royankush/KRSSG/Mech Team Repo/SSL Bots Designs/SSL Bots V3 - 3D Printed/SSL V3 Proto Assembly.JPG

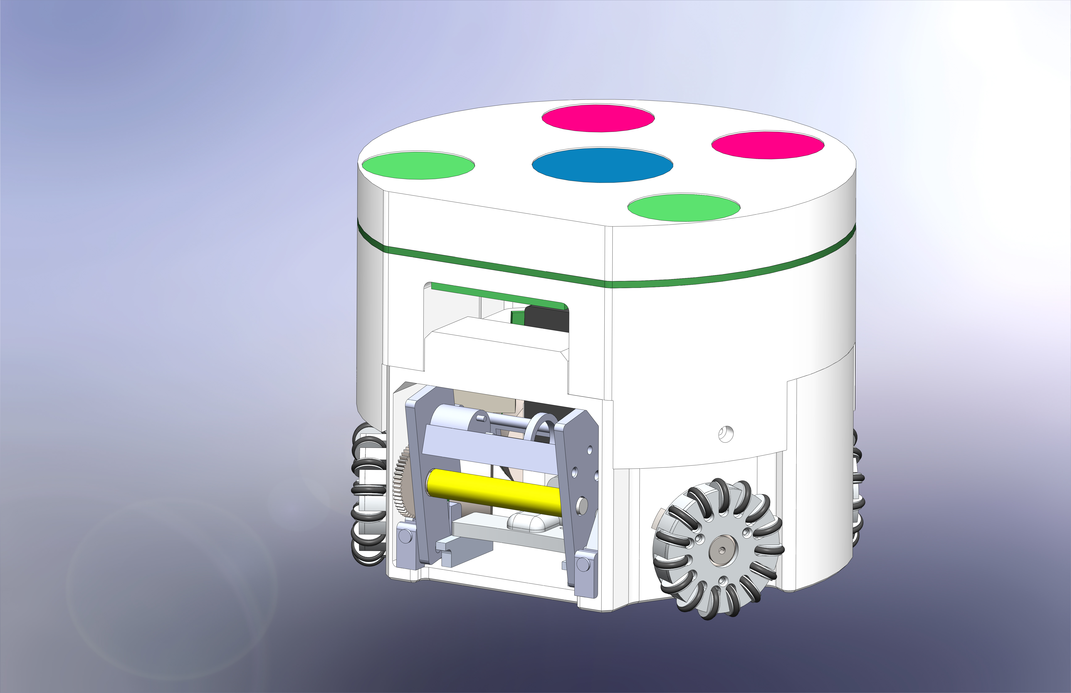
Mech Team Repo/SSL Bots Designs/SSL Bots V3 - 3D Printed/SSL V3 Proto Assembly.JPG
