royankush/KRSSG/Mech Team Repo/SSL Bots Designs/SSL Bots V2 - 2016/render.JPG

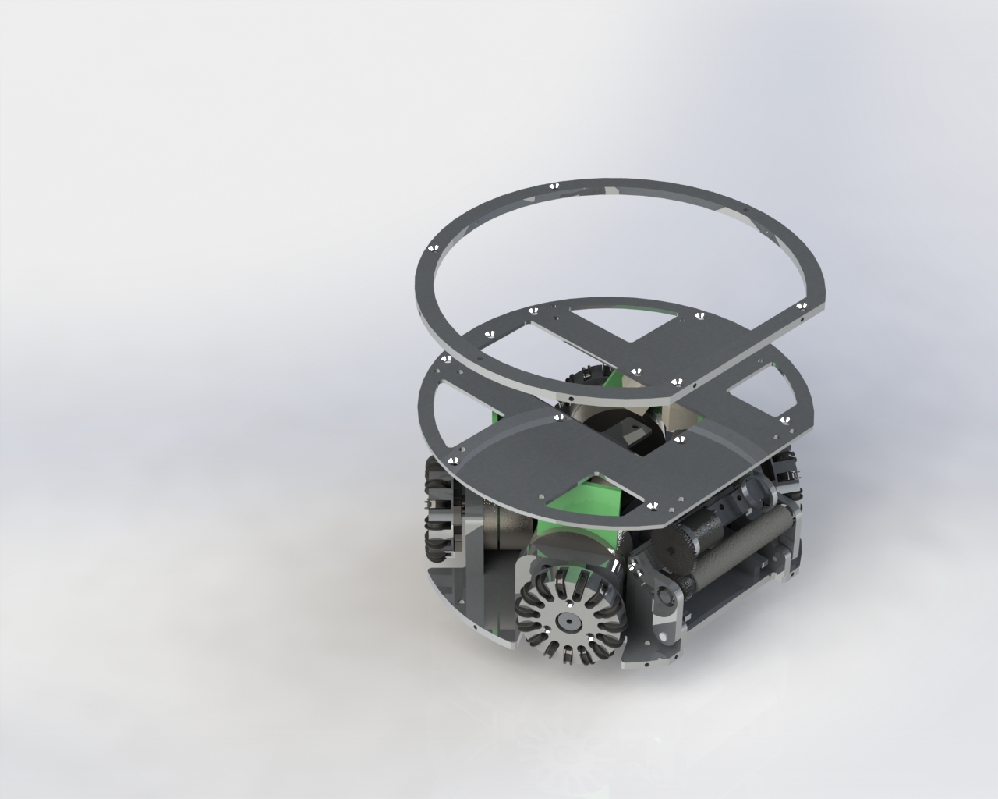
Mech Team Repo/SSL Bots Designs/SSL Bots V2 - 2016/render.JPG
