royankush/KRSSG/README.md

# KRSSG
KRSSG Repository - Mechanical design, simulations, codes and other stuff
