royankush/KRSSG/Mech Team Repo/Humanoid/humanoid_bot.md

This is a repo of humanoid robot simulations and CAD
