royankush/KRSSG/Mech Team Repo/SSL Bots Designs/EC45 motor modification.pdf

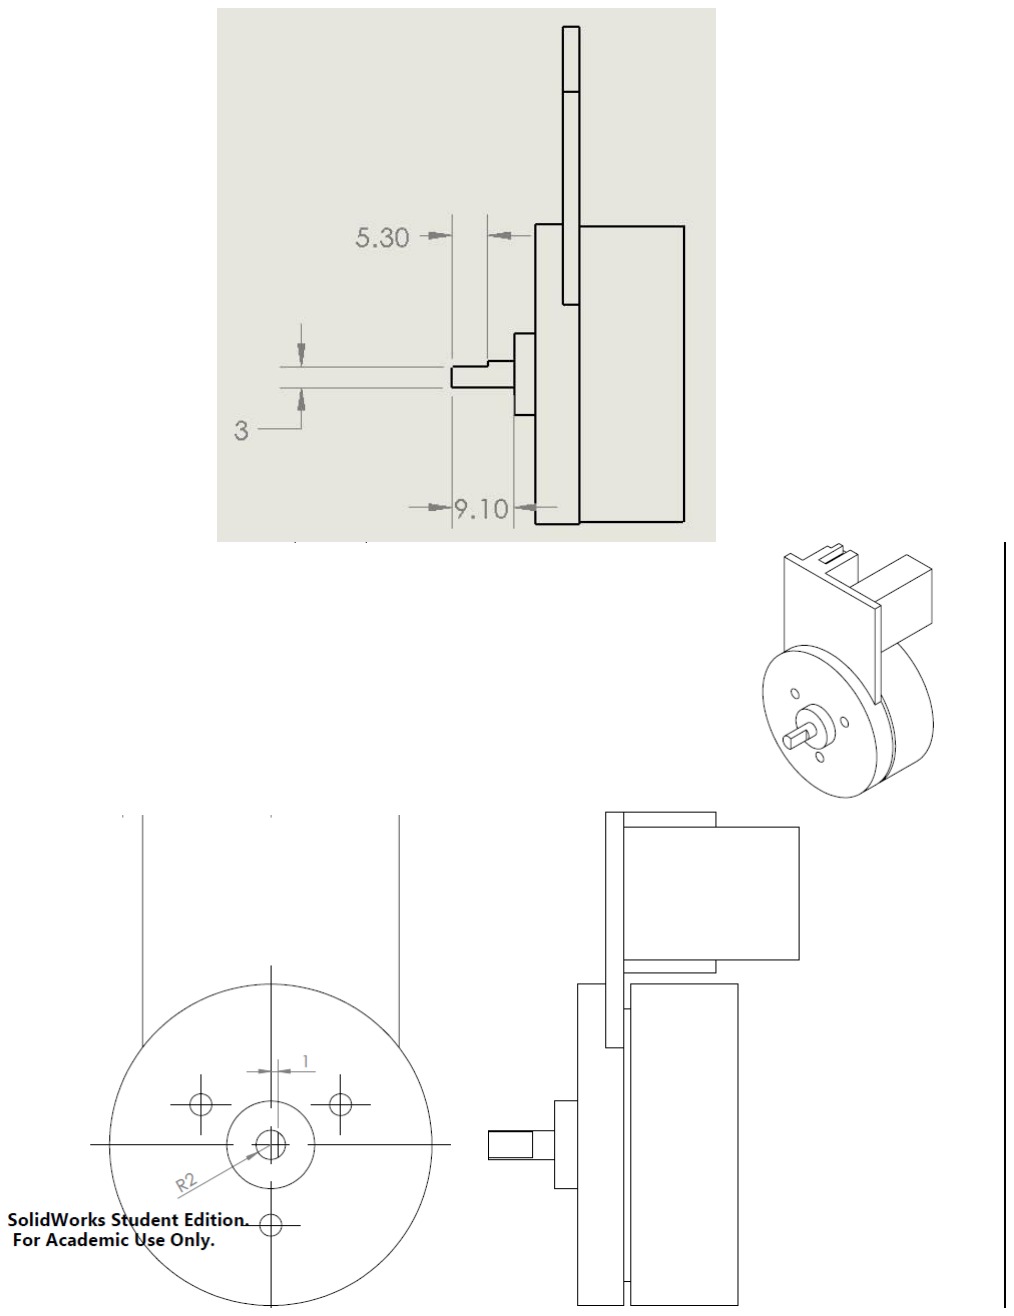
[picture p62: page 1]
