royankush/KRSSG/Mech Team Repo/Bills and Misc/Bosch toolbox.pdf

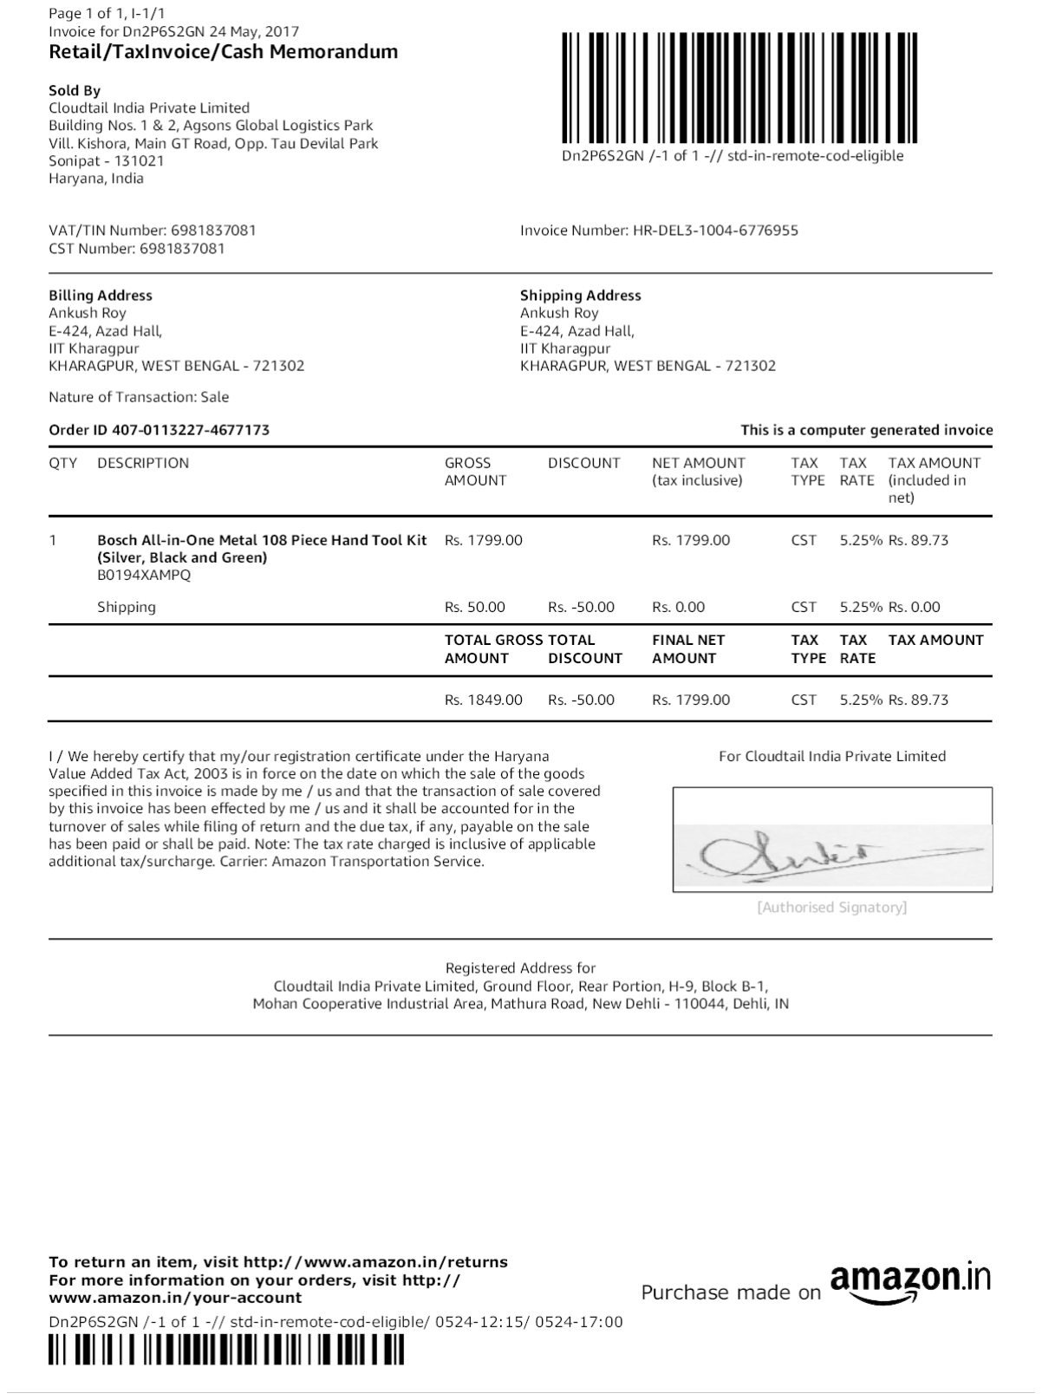
[picture p63: page 1]
