royankush/KRSSG/Mech Team Repo/Bills and Misc/SSL_v2_bill_2.jpg

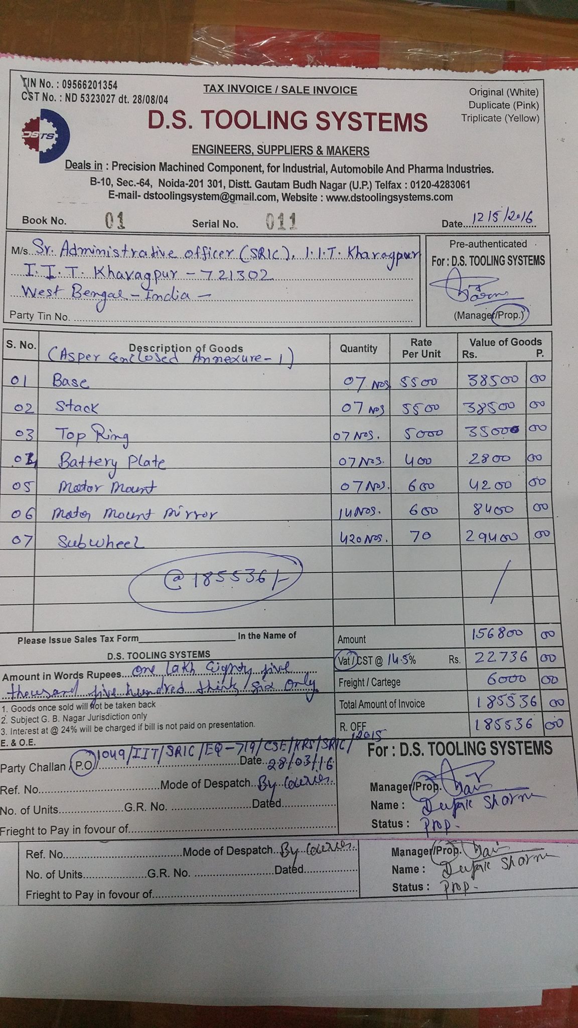
Mech Team Repo/Bills and Misc/SSL_v2_bill_2.jpg
