royankush/KRSSG/Mech Team Repo/Bills and Misc/SSL_v2_bills.jpg

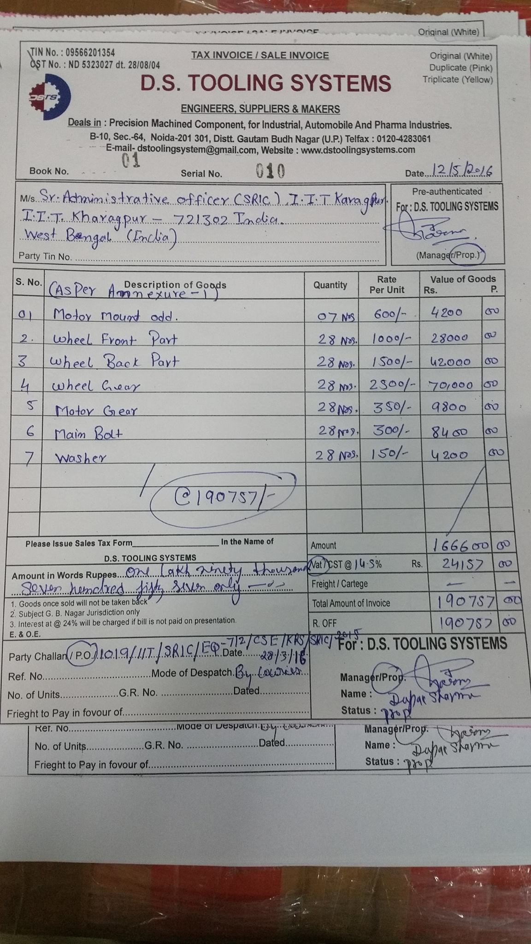
Mech Team Repo/Bills and Misc/SSL_v2_bills.jpg
