royankush/KRSSG/Mech Team Repo/Markers/full_b.jpg

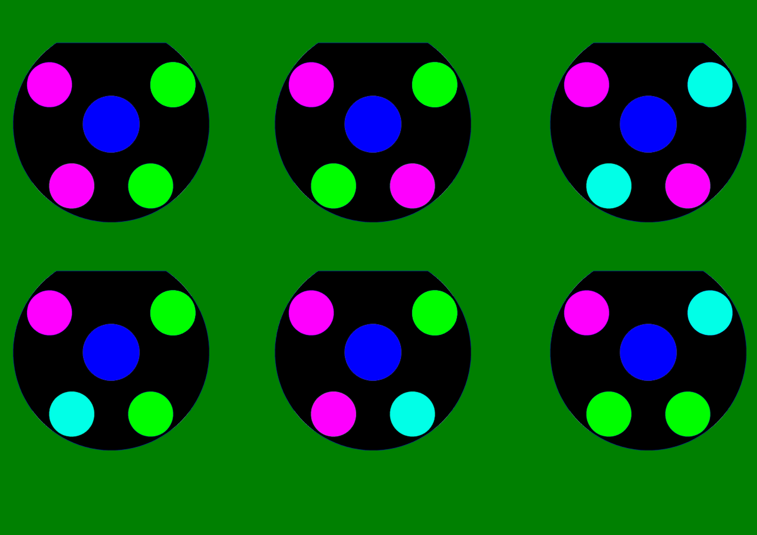
Mech Team Repo/Markers/full_b.jpg
