royankush/KRSSG/Mech Team Repo/Markers/full_y.jpg

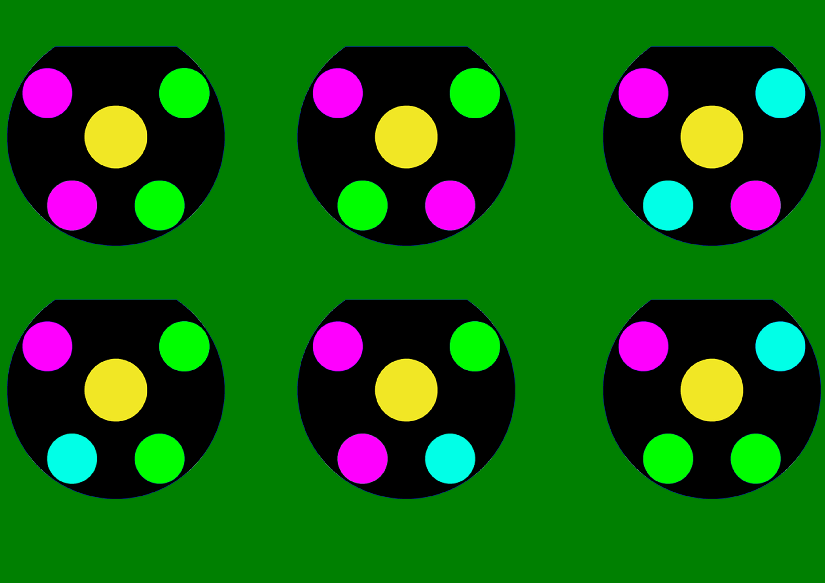
Mech Team Repo/Markers/full_y.jpg
