royankush/KRSSG/Mech Team Repo/Markers/m1.jpg

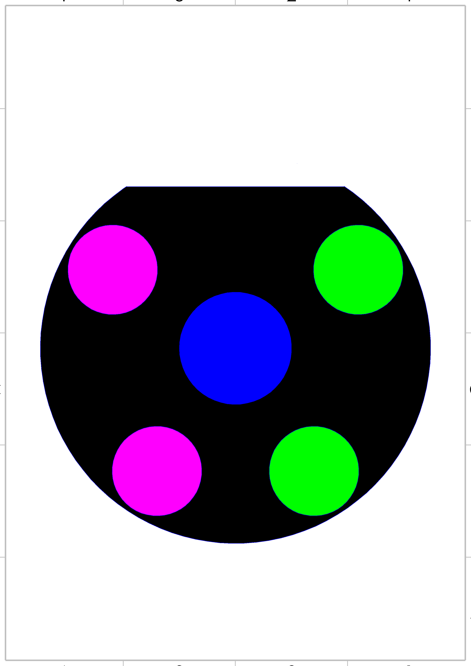
Mech Team Repo/Markers/m1.jpg
