royankush/KRSSG/Mech Team Repo/Markers/Marker.JPG

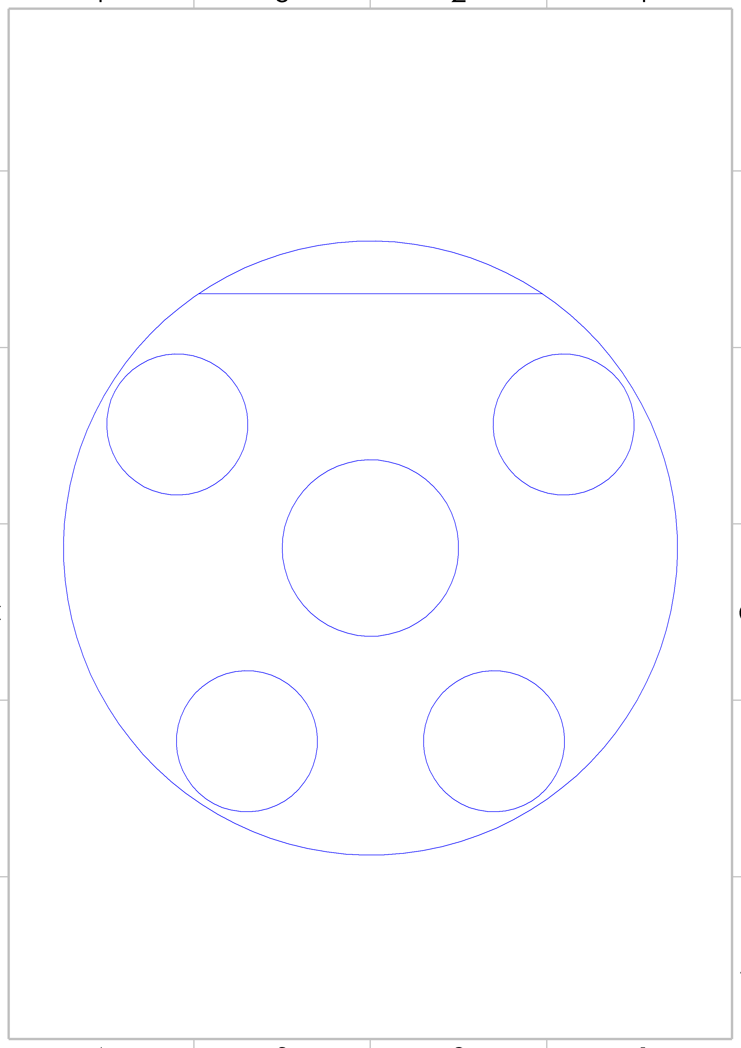
Mech Team Repo/Markers/Marker.JPG
