royankush/KRSSG/Mech Team Repo/KRSSG Mech Team- Expenses Record.xlsx

Sheet: 2018
Date of Order/Purchase | Date Recieved | Invoice No | Item | Vendor | Quantity | Total Amount | Purchaser's Name | Paid By | Type | Remarks
2018-03-24 | 2018-03-24 | 1605889 | KRSSG website renewal | BigRock | 1 | 3525 | Ankush | Ankush | Advance
2018-03-24 | 2018-03-24 |  | White Board and accessories | Thackers | 1 | 1058 | Ankush | Ankush | Advance
2018-03-25 | 2018-04-06 | MH-177761811-1718 | Firewre Card | Amazon | 1 | 3004 | Ankush | Ankush | Advance
2018-04-01 | 2018-04-13 | MH-147384671-1819 | Gel Pad | Amazon | 1 | 1390 | Ankush | Ankush | Advance
2018-05-19 |  | 20 | Dribbler V2 Prototype | Confio Engineering Solutions | 1 | 16343 | Shivam | Tanishq | Reimbursement
2018-07-20 |  | 59 | Dribbler V2 Proto and Assembly | Confio Engineering Solutions | 1 | 14514 | Prince | Tanishq | Reimbursement
2018-07-28 | 2018-07-28 | 645 | Fateners and Studs | Buraaq Enterprises | 1 | 849 | Ankush | Ankush | Reimbursement
2018-07-28 | 2018-07-28 | 724902 | Fasteners and Spacers | JC Gupta & Sons | 1 | 684 | Ankush | Ankush | Reimbursement

Sheet: 2017
Date of Order/Purchase | Date Recieved | Invoice No | Item | Quantity | Total Amount | Purchaser's Name | Paid By | Type | Remark
2017-02-05 | 2017-02-20 |  | Solenoid Winding from electrical service section | 3 | 750 | Ankush | Ankush | Reimbursement
2017-04-05 | 2017-04-05 |  | Cover Filing | 1 | 200 | Aditya | Aditya | Reimbursement |  | Note the dates are approx.
2017-05-15 | 2017-05-25 |  | Solenoid winding Chhotu Da | 3 | 750 | Ankush | Ankush | Reimbursement |  | How the contri amount has been utilized unknown
2017-05-24 | 2017-05-30 | HR-DEL3-1004-6776955 | Bosch Toolbox | 1 | 1850 | Ankush | Contri | Reimbursement |  | All items bought not there
2017-05-25 | 2017-06-01 |  | Winding | 1 | 300 | Aditya | Aditya | Reimbursement
2017-09-01 | 2017-09-01 |  | Arena Makeover | 1 | 500 | Sahoo | Ankush | Reimbursement | Total amount was 3500
2017-09-01 | 2017-09-01 |  | Arena Makeover | 1 | 500 | Sahoo | Adiya | Reimbursement | Total amount was 3500
2017-09-05 | 2017-09-15 | WB-175050041-1718 | Loctite Threadlocker | 1 | 940 | Ankush | Contri | Reimbursement

Sheet: Contri Amount
Member Name | 2016 | 2017 | 2018 | 2019 | Total
Aditya | 500 | 600 |  |  | 1100
Ankush | 500 | 1000 |  |  | 1500 | Please note this sheet is only for contri amount and not for individual expense
Kewal | 500 |  |  |  | 500
Vedansh | 500 | 1000 |  |  | 1500
Vinay | 500 | 500 |  |  | 1000
Dhananjay |  | 500 |  |  | 500
Harsh |  | 500 |  |  | 500
Prince |  | 500 |  |  | 500
Shail |  | 500 |  |  | 500
Shivam |  | 500 |  |  | 500
Virat |  | 500 |  |  | 500
