royankush/KRSSG/Mech Team Repo/Bills and Misc/Maxon motors purchase order.pdf

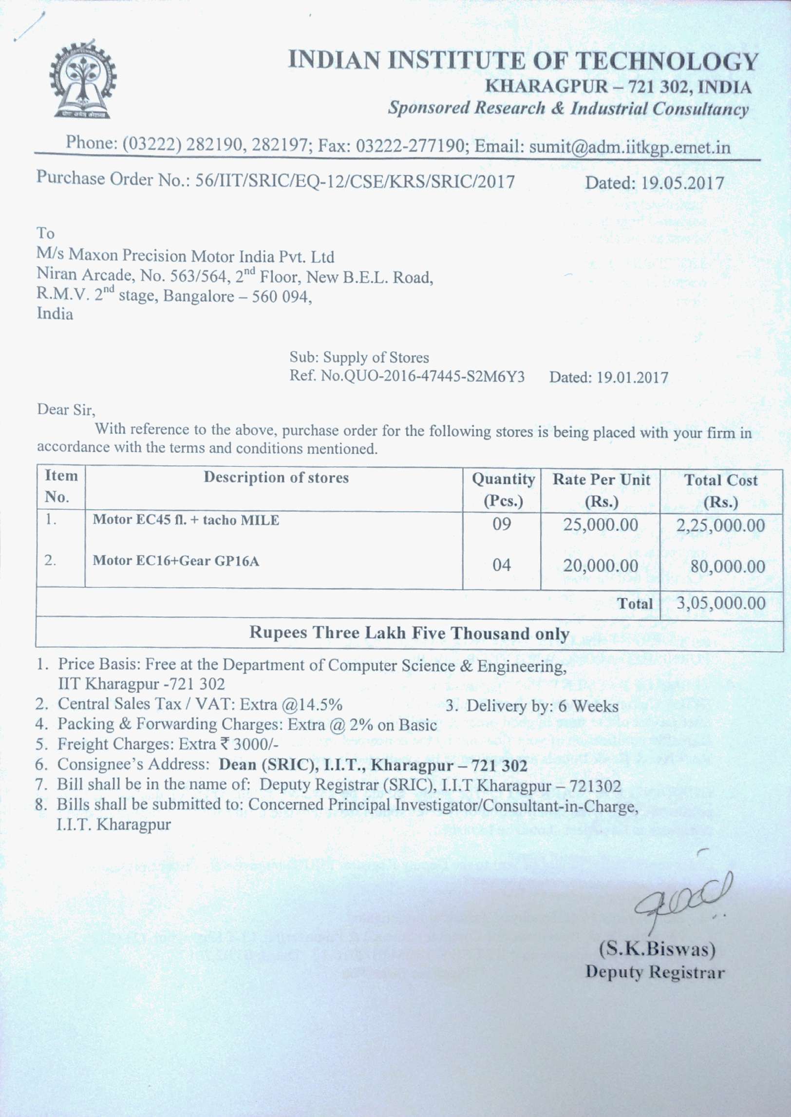
[picture p70: page 1]

Scanned by CamScanner

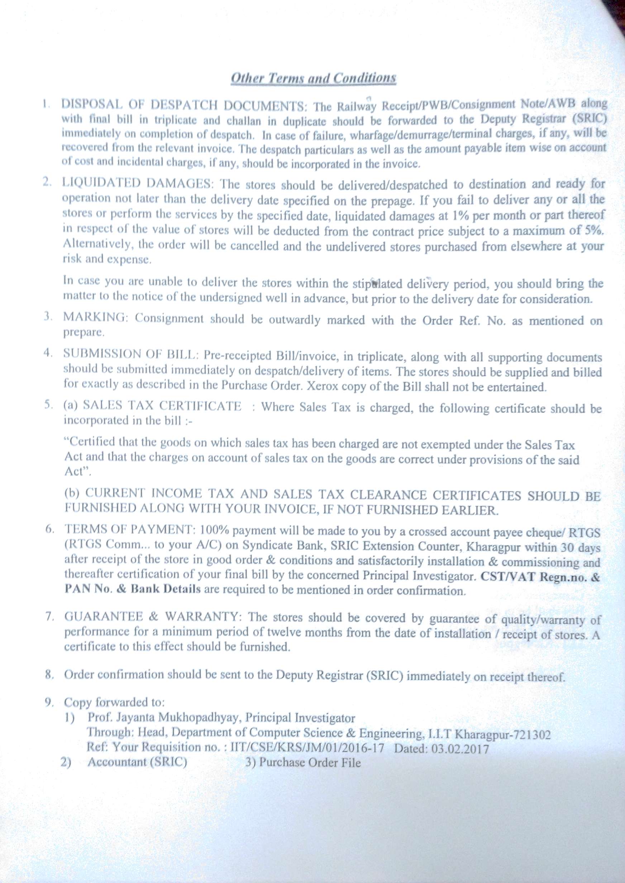
[picture p71: page 2]
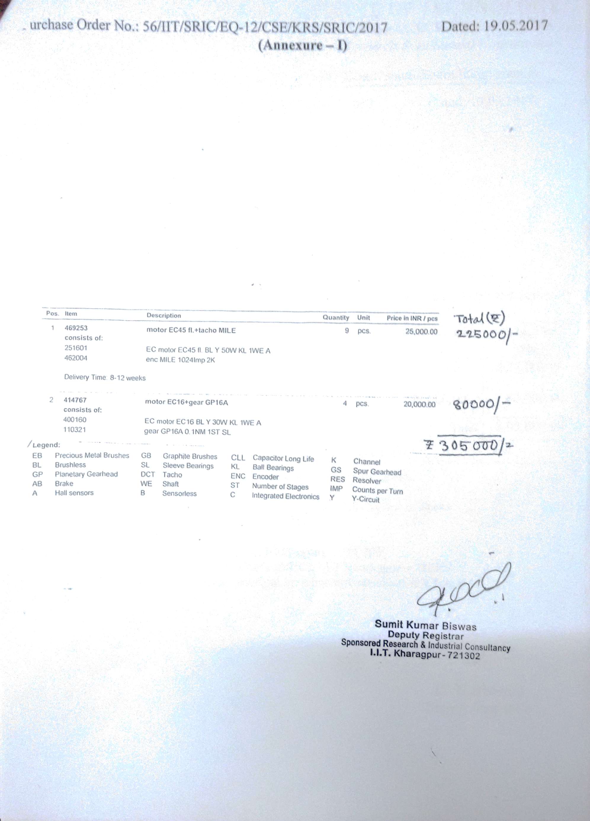
[picture p72: page 3]
