royankush/KRSSG/Mech Team Repo/SSL Bots Designs/SSL Bots V3 - 3D Printed/Main Body, Base.SLDPRT

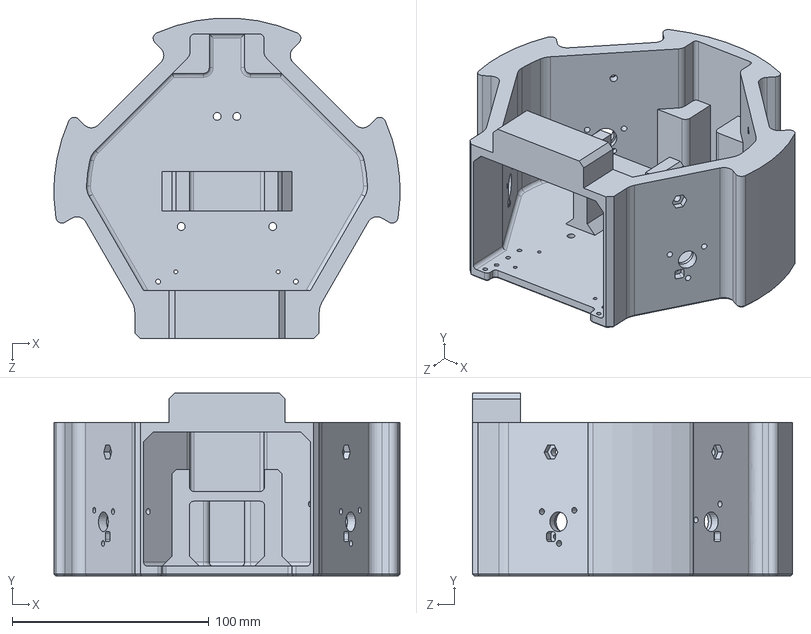
[picture p73: CAD file, 2022-12-06]
Mech Team Repo/SSL Bots Designs/SSL Bots V3 - 3D Printed/Main Body, Base.SLDPRT
175.8 x 93.0 x 162.8 mm
