royankush/KRSSG/Mech Team Repo/SSL Bots Designs/SSL Bots V3 - 3D Printed/SSL V3 Proto Assembly.SLDASM

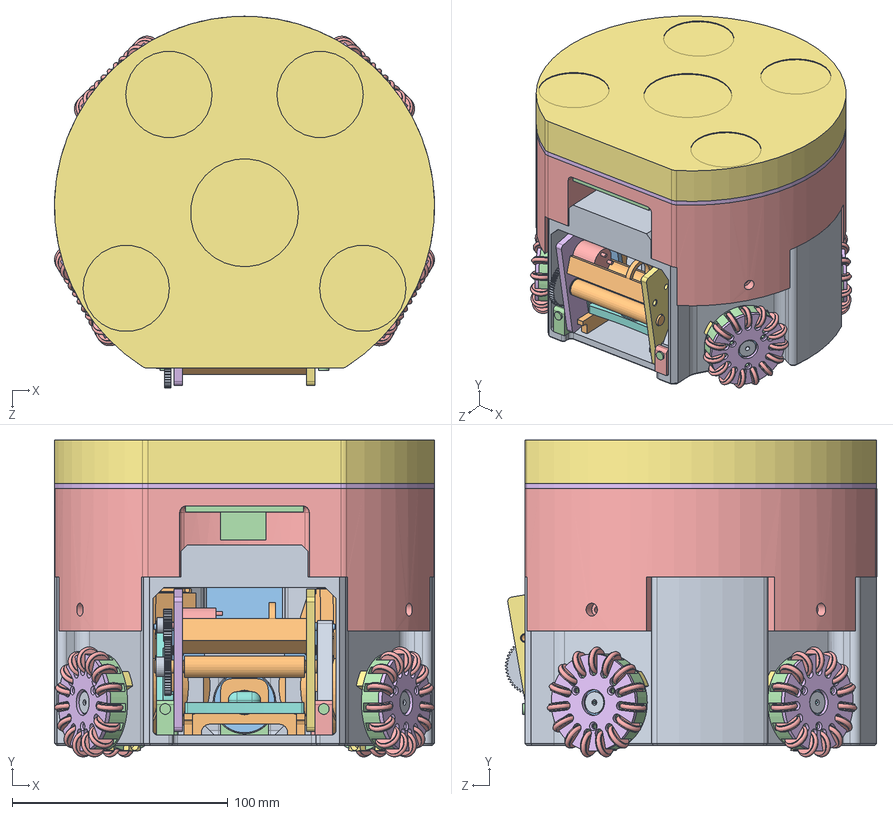
[picture p74: CAD file, 2022-12-06]
Mech Team Repo/SSL Bots Designs/SSL Bots V3 - 3D Printed/SSL V3 Proto Assembly.SLDASM
175.9 x 146.7 x 172.1 mm
Main Body, Base
MAXON motor x 4
radial ball bearing_68_am x 6
back part x 4
subwheel x 60
front part x 4
wheel gear x 4
main bolt x 4
washer x 4
DV2Dribbler Rod
DV2middle_rod
DV2Side_lower_base_left
DV2Side_lower_base_right
DV2side_mount_left
DV2side_mount_right
DV2side_upper_base_left_modified (2)
DV2side_upper_base_right_modified -
DV2Motor Mount 2
DV2hinge_slot_new
DV2Lower support x 2
DV2drib gear box
DV2Pin x 2
hex flange machine screw_am x 2
hex nut style 1_am x 4
spur gear_am x 2
1 straight front support
1 straight shell
1 straight rear support
1 straight plunger
1 straight plunger rear
1 straight kicker middle
1 straight kicker front
coil
Plunger support x 2
Battery
Kicker_circuit
Circuit Holder
Main_Board
TopPlate
