royankush/KRSSG/Mech Team Repo/SSL Bots Designs/SSL Bots V2 - 2016/new ssl bot.SLDASM

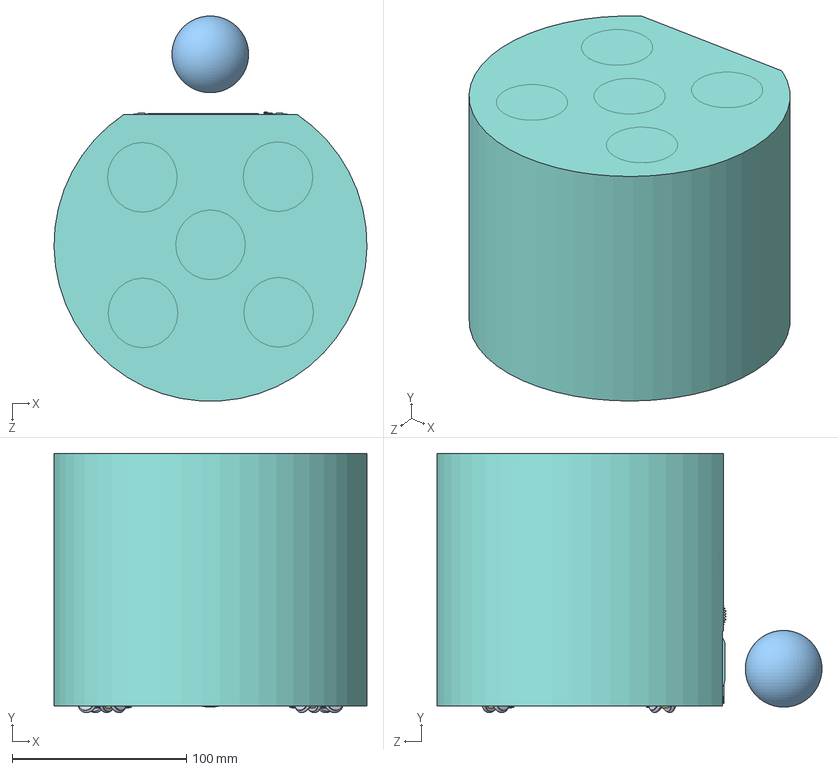
[picture p75: CAD file, 2025-08-10]
Mech Team Repo/SSL Bots Designs/SSL Bots V2 - 2016/new ssl bot.SLDASM
179.5 x 148.7 x 220.8 mm
new base
stack
top ring
motor mount
MAXON motor x 4
motor gear x 4
radial ball bearing_68_am x 4
back part x 4
subwheel x 60
front part x 4
wheel gear x 4
main bolt x 4
washer x 4
motor mount mirror x 2
1 side support left
1 side support right
1 dribbler mount middle
1 motor rear support
1 motor front support
drib gear box
1 dribbler rod
1 rod gear
1 dribbler motor gear
dribbler side mount
dribbler side mount mirror
1 dribbler support middle
Pin x 2
1 straight front support
1 straight shell
1 straight rear support
1 straight plunger
1 straight plunger rear
1 straight kicker middle
1 straight kicker front
coil
solenoid shield
chip holder x 2
battery plate
motor mount odd
Standoff 60mm x 4
Standoff 72mm x 4
Ball
