royankush/KRSSG/Mech Team Repo/SSL Bots Designs/SSL Bots V2 - 2016/Standoff 60mm.SLDPRT

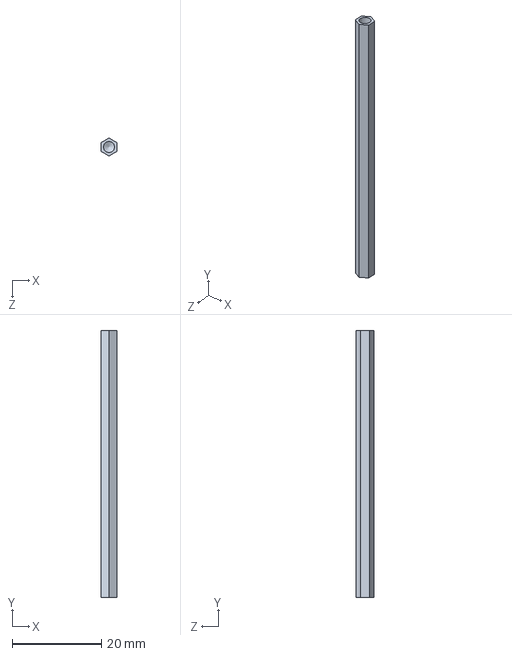
[picture p76: CAD file, 2025-08-10]
Mech Team Repo/SSL Bots Designs/SSL Bots V2 - 2016/Standoff 60mm.SLDPRT
3.50 x 60.0 x 4.04 mm
