royankush/KRSSG/Mech Team Repo/SSL Bots Designs/SSL Bots V3 - 3D Printed/Test_Proto.SLDPRT

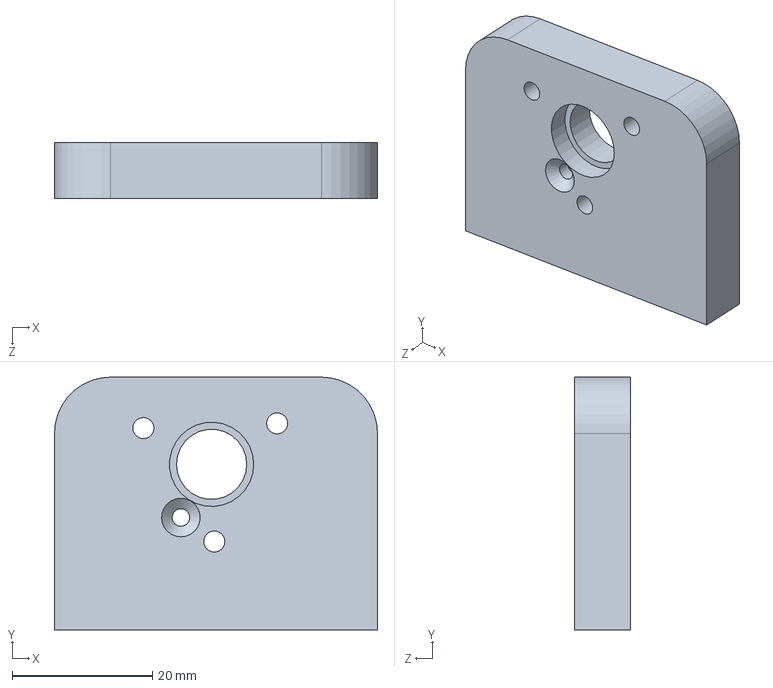
[picture p77: CAD file, 2022-12-06]
Mech Team Repo/SSL Bots Designs/SSL Bots V3 - 3D Printed/Test_Proto.SLDPRT
46.0 x 36.0 x 8.00 mm
