royankush/KRSSG/Mech Team Repo/SSL Bots Designs/SSL Bots V2 - 2016/Standoff 35mm.SLDPRT

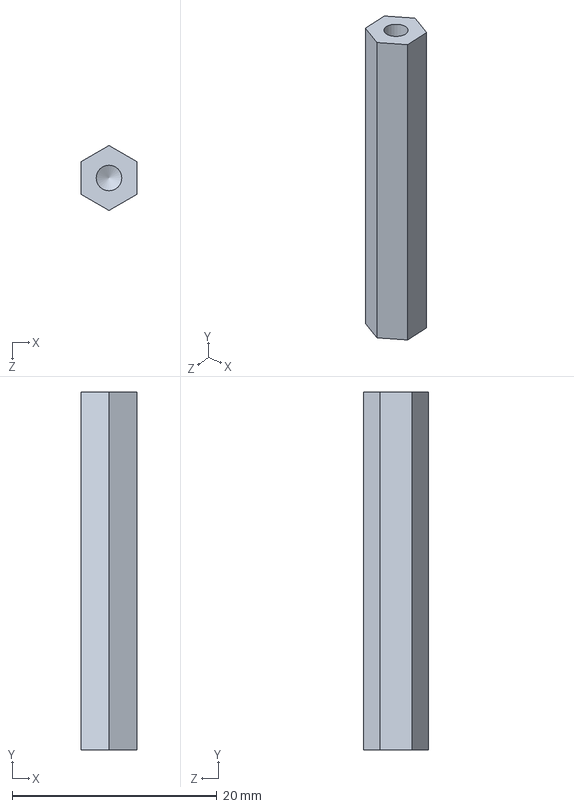
[picture p78: CAD file, 2025-08-10]
Mech Team Repo/SSL Bots Designs/SSL Bots V2 - 2016/Standoff 35mm.SLDPRT
5.50 x 35.0 x 6.35 mm
