royankush/KRSSG/Mech Team Repo/SSL Bots Designs/SSL Bots V3 - 3D Printed/Circuit Holder.SLDPRT

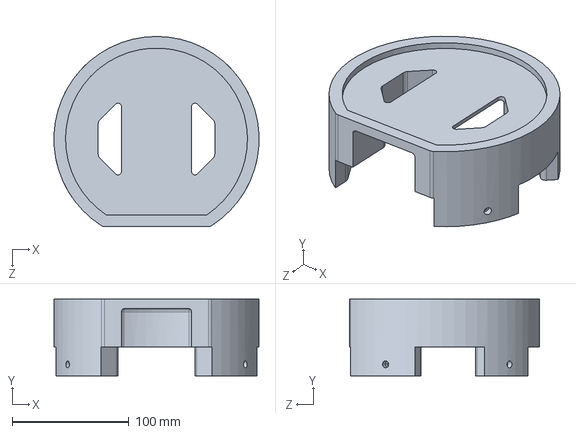
[picture p79: CAD file, 2022-12-06]
Mech Team Repo/SSL Bots Designs/SSL Bots V3 - 3D Printed/Circuit Holder.SLDPRT
175.8 x 66.0 x 163.0 mm
