royankush/KRSSG/Mech Team Repo/SSL Bots Designs/SSL Bots V2 - 2016/top ring.SLDPRT

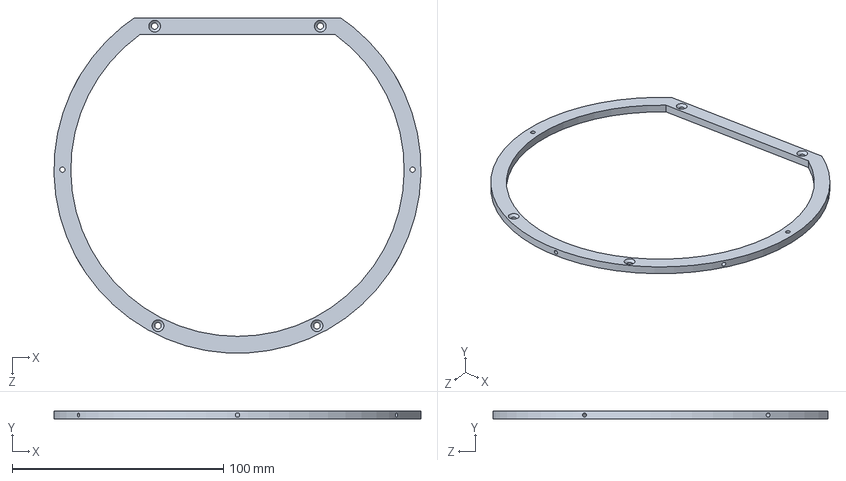
[picture p80: CAD file, 2025-08-10]
Mech Team Repo/SSL Bots Designs/SSL Bots V2 - 2016/top ring.SLDPRT
173.9 x 4.00 x 159.0 mm
