royankush/KRSSG/Mech Team Repo/SSL Bots Designs/SSL Bots V2 - 2016/stack.SLDPRT

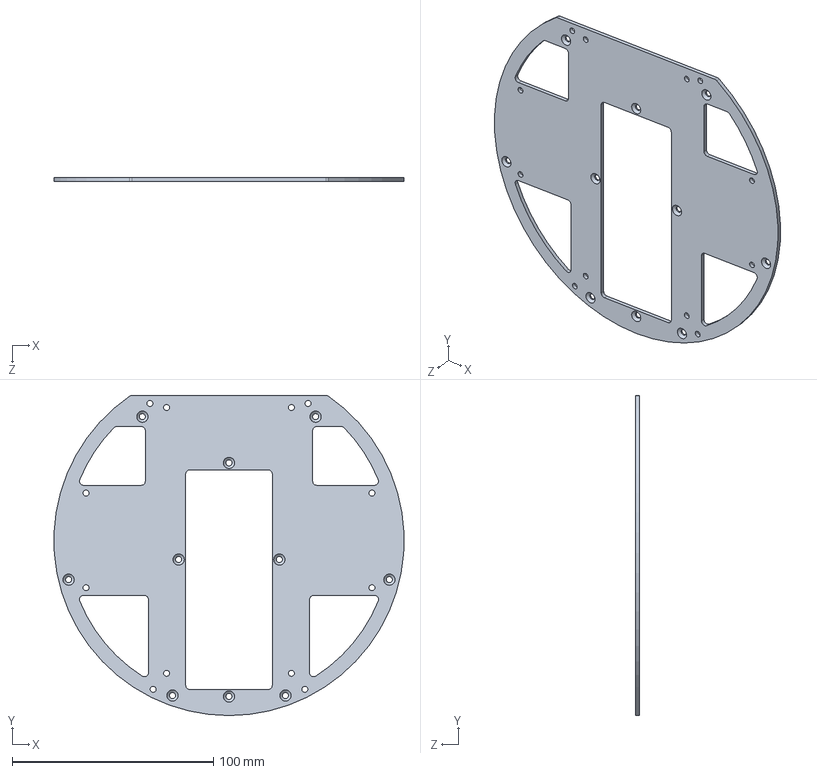
[picture p81: CAD file, 2025-08-10]
Mech Team Repo/SSL Bots Designs/SSL Bots V2 - 2016/stack.SLDPRT
173.8 x 159.0 x 2.00 mm
