royankush/KRSSG/Mech Team Repo/SSL Bots Designs/SSL Bots V2 - 2016/Standoff 72mm.SLDPRT

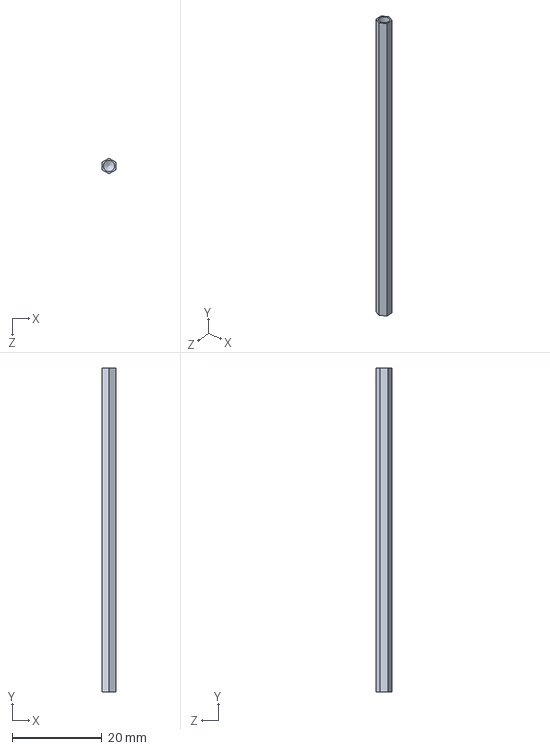
[picture p82: CAD file, 2025-08-10]
Mech Team Repo/SSL Bots Designs/SSL Bots V2 - 2016/Standoff 72mm.SLDPRT
3.00 x 72.0 x 3.46 mm
