royankush/KRSSG/Mech Team Repo/SSL Bots Designs/SSL Bots V3 - 3D Printed/Battery.SLDPRT

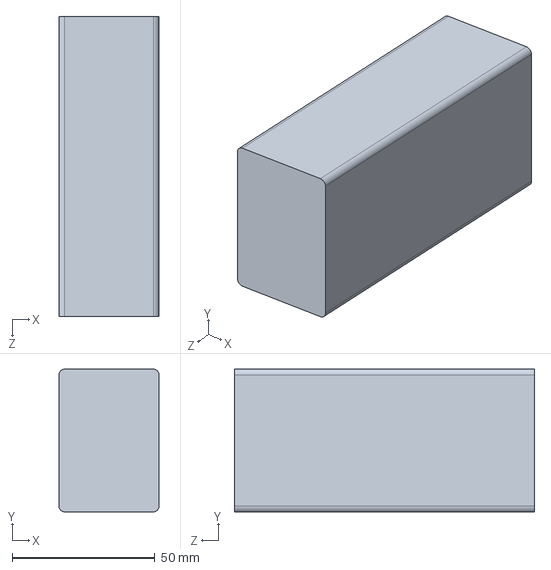
[picture p83: CAD file, 2022-12-06]
Mech Team Repo/SSL Bots Designs/SSL Bots V3 - 3D Printed/Battery.SLDPRT
35.0 x 50.0 x 105.0 mm
