royankush/KRSSG/Mech Team Repo/SSL Bots Designs/SSL Bots V2 - 2016/new base.SLDPRT

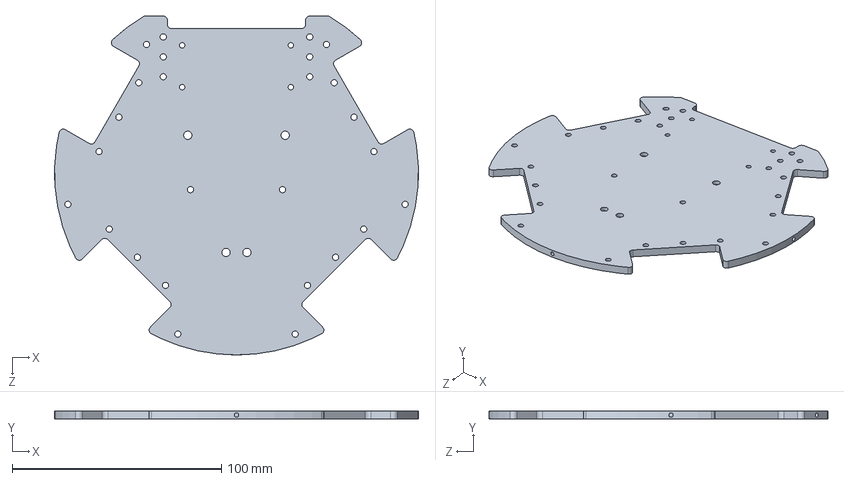
[picture p84: CAD file, 2025-08-10]
Mech Team Repo/SSL Bots Designs/SSL Bots V2 - 2016/new base.SLDPRT
174.0 x 4.00 x 162.0 mm
