royankush/KRSSG/Mech Team Repo/SSL Bots Designs/SSL Bots V3 - 3D Printed/TopPlate.SLDPRT

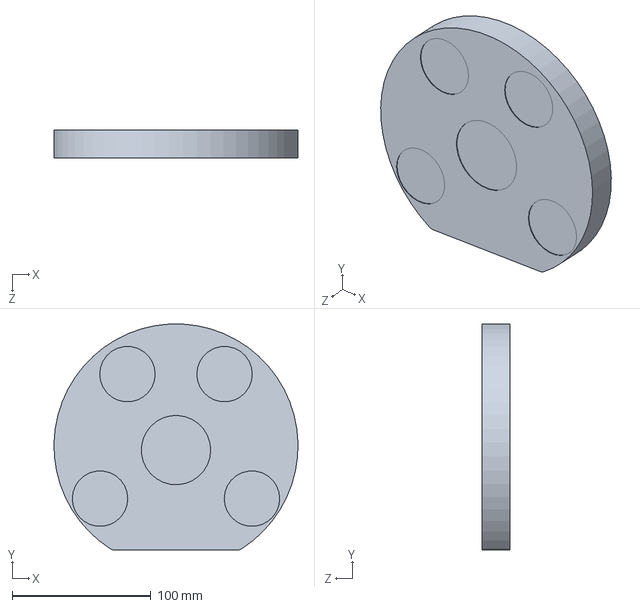
[picture p85: CAD file, 2022-12-06]
Mech Team Repo/SSL Bots Designs/SSL Bots V3 - 3D Printed/TopPlate.SLDPRT
175.9 x 162.9 x 20.0 mm
