royankush/KRSSG/Mech Team Repo/SSL Bots Designs/SSL Bots V2 - 2016/battery plate.SLDPRT

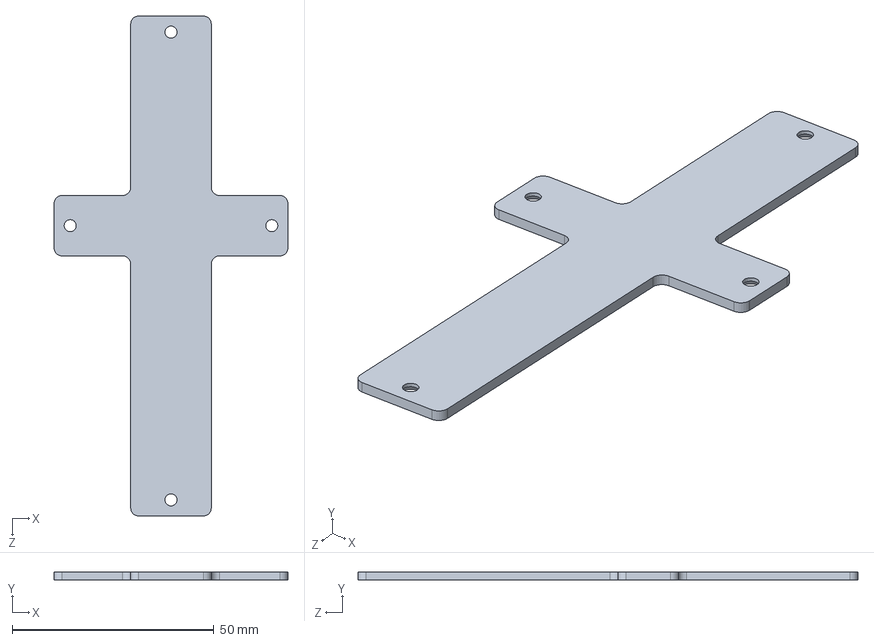
[picture p86: CAD file, 2025-08-10]
Mech Team Repo/SSL Bots Designs/SSL Bots V2 - 2016/battery plate.SLDPRT
58.0 x 2.00 x 124.0 mm
