royankush/KRSSG/Mech Team Repo/SSL Bots Designs/SSL Bots V2 - 2016/chip holder.SLDPRT

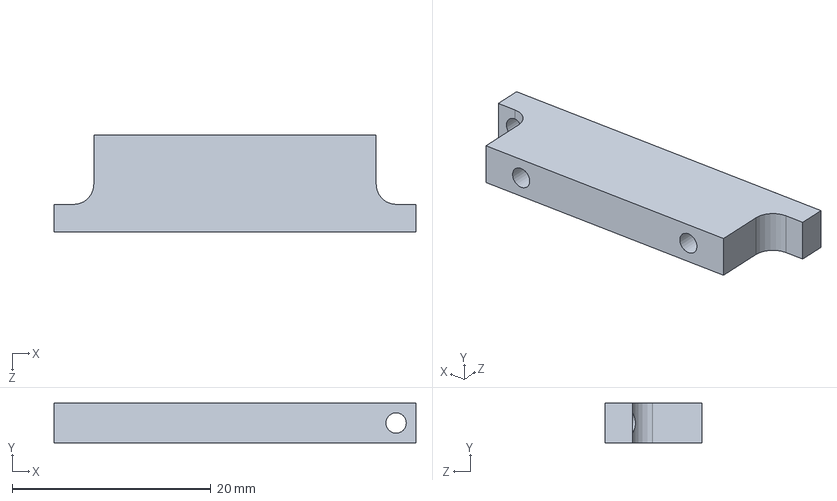
[picture p87: CAD file, 2025-08-10]
Mech Team Repo/SSL Bots Designs/SSL Bots V2 - 2016/chip holder.SLDPRT
36.4 x 4.00 x 9.80 mm
