royankush/KRSSG/Mech Team Repo/SSL Bots Designs/SSL Bots V2 - 2016/Ball.SLDPRT

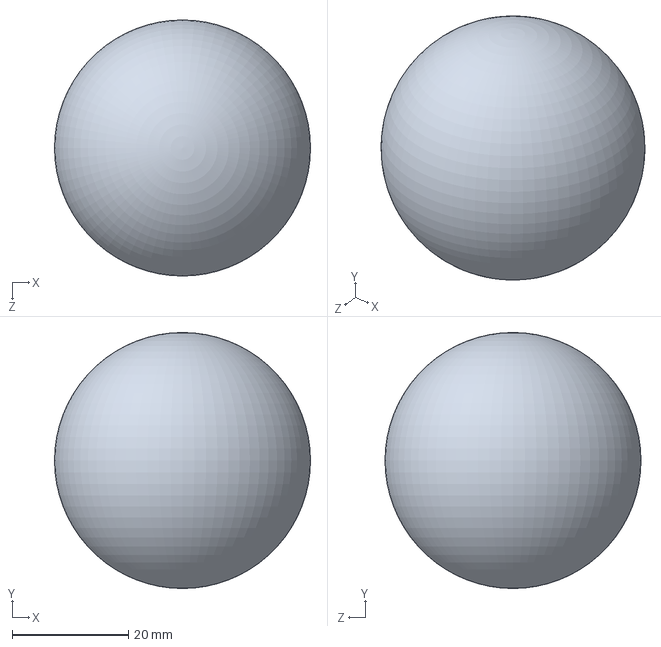
[picture p88: CAD file, 2025-08-10]
Mech Team Repo/SSL Bots Designs/SSL Bots V2 - 2016/Ball.SLDPRT
44.0 x 44.0 x 44.0 mm
