royankush/KRSSG/Mech Team Repo/SSL Bots Designs/SSL Bots V3 - 3D Printed/ssl_bots_v3.md

This is a repo of CAD files of 3D printable SSL Bots
