royankush/KRSSG/Mech Team Repo/Manufacturer Details - Contact and Reviews.xlsx

Manufacturer Name | Expertise | Location | Contact | Rating (Out of 5) | Reviews
DS Tooling Systems | Precision Machining | Delhi |  | 3
