royankush/KRSSG/Mech Team Repo/SSL Bots Designs/EC16 motor modification.PDF

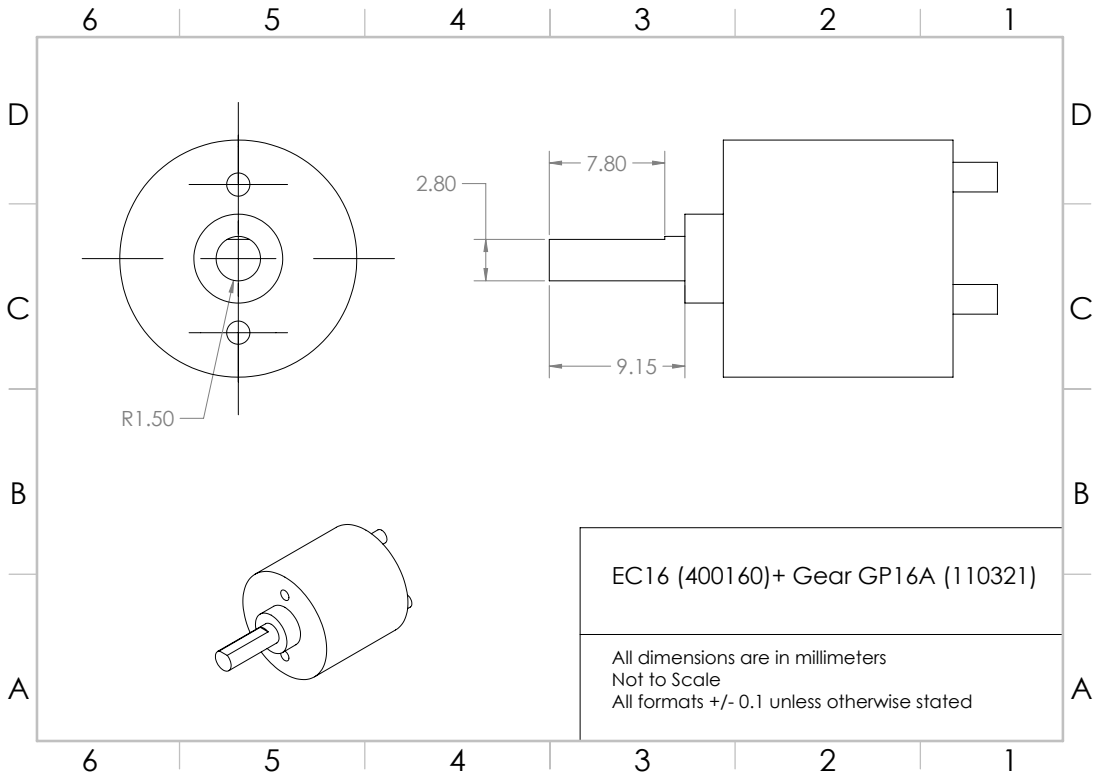
[picture p89: page 1]
EC16 (400160)+ Gear GP16A (110321); Not to Scale A; All formats +/- 0.1 unless otherwise stated

All dimensions are in millimeters
